pratyush-pangotra/Machine-black-box/firmware/mbb_main/secrets.example.h

// Copy this file to secrets.h (in this same folder) and fill in your own values.
// secrets.h is listed in .gitignore, so your WiFi password never goes to GitHub.
#pragma once

#define MBB_WIFI_SSID     "YOUR_HOTSPOT_NAME"       // "" = USB cable only
#define MBB_WIFI_PASSWORD "YOUR_HOTSPOT_PASSWORD"
#define MBB_MQTT_HOST     "192.168.43.100"          // the laptop's IP address on the hotspot
